tuhin37/VI-Analyzer/README.md

# VI-Analyzer
VI-Analyzer measures DC parameters like terminal voltage and load current with great precesion and loggs them
