tuhin37/VI-Analyzer/eagle/VI Analyzer/VI meter.brd

## EAGLE design eagle/VI Analyzer/VI meter.brd (2018-12-23)

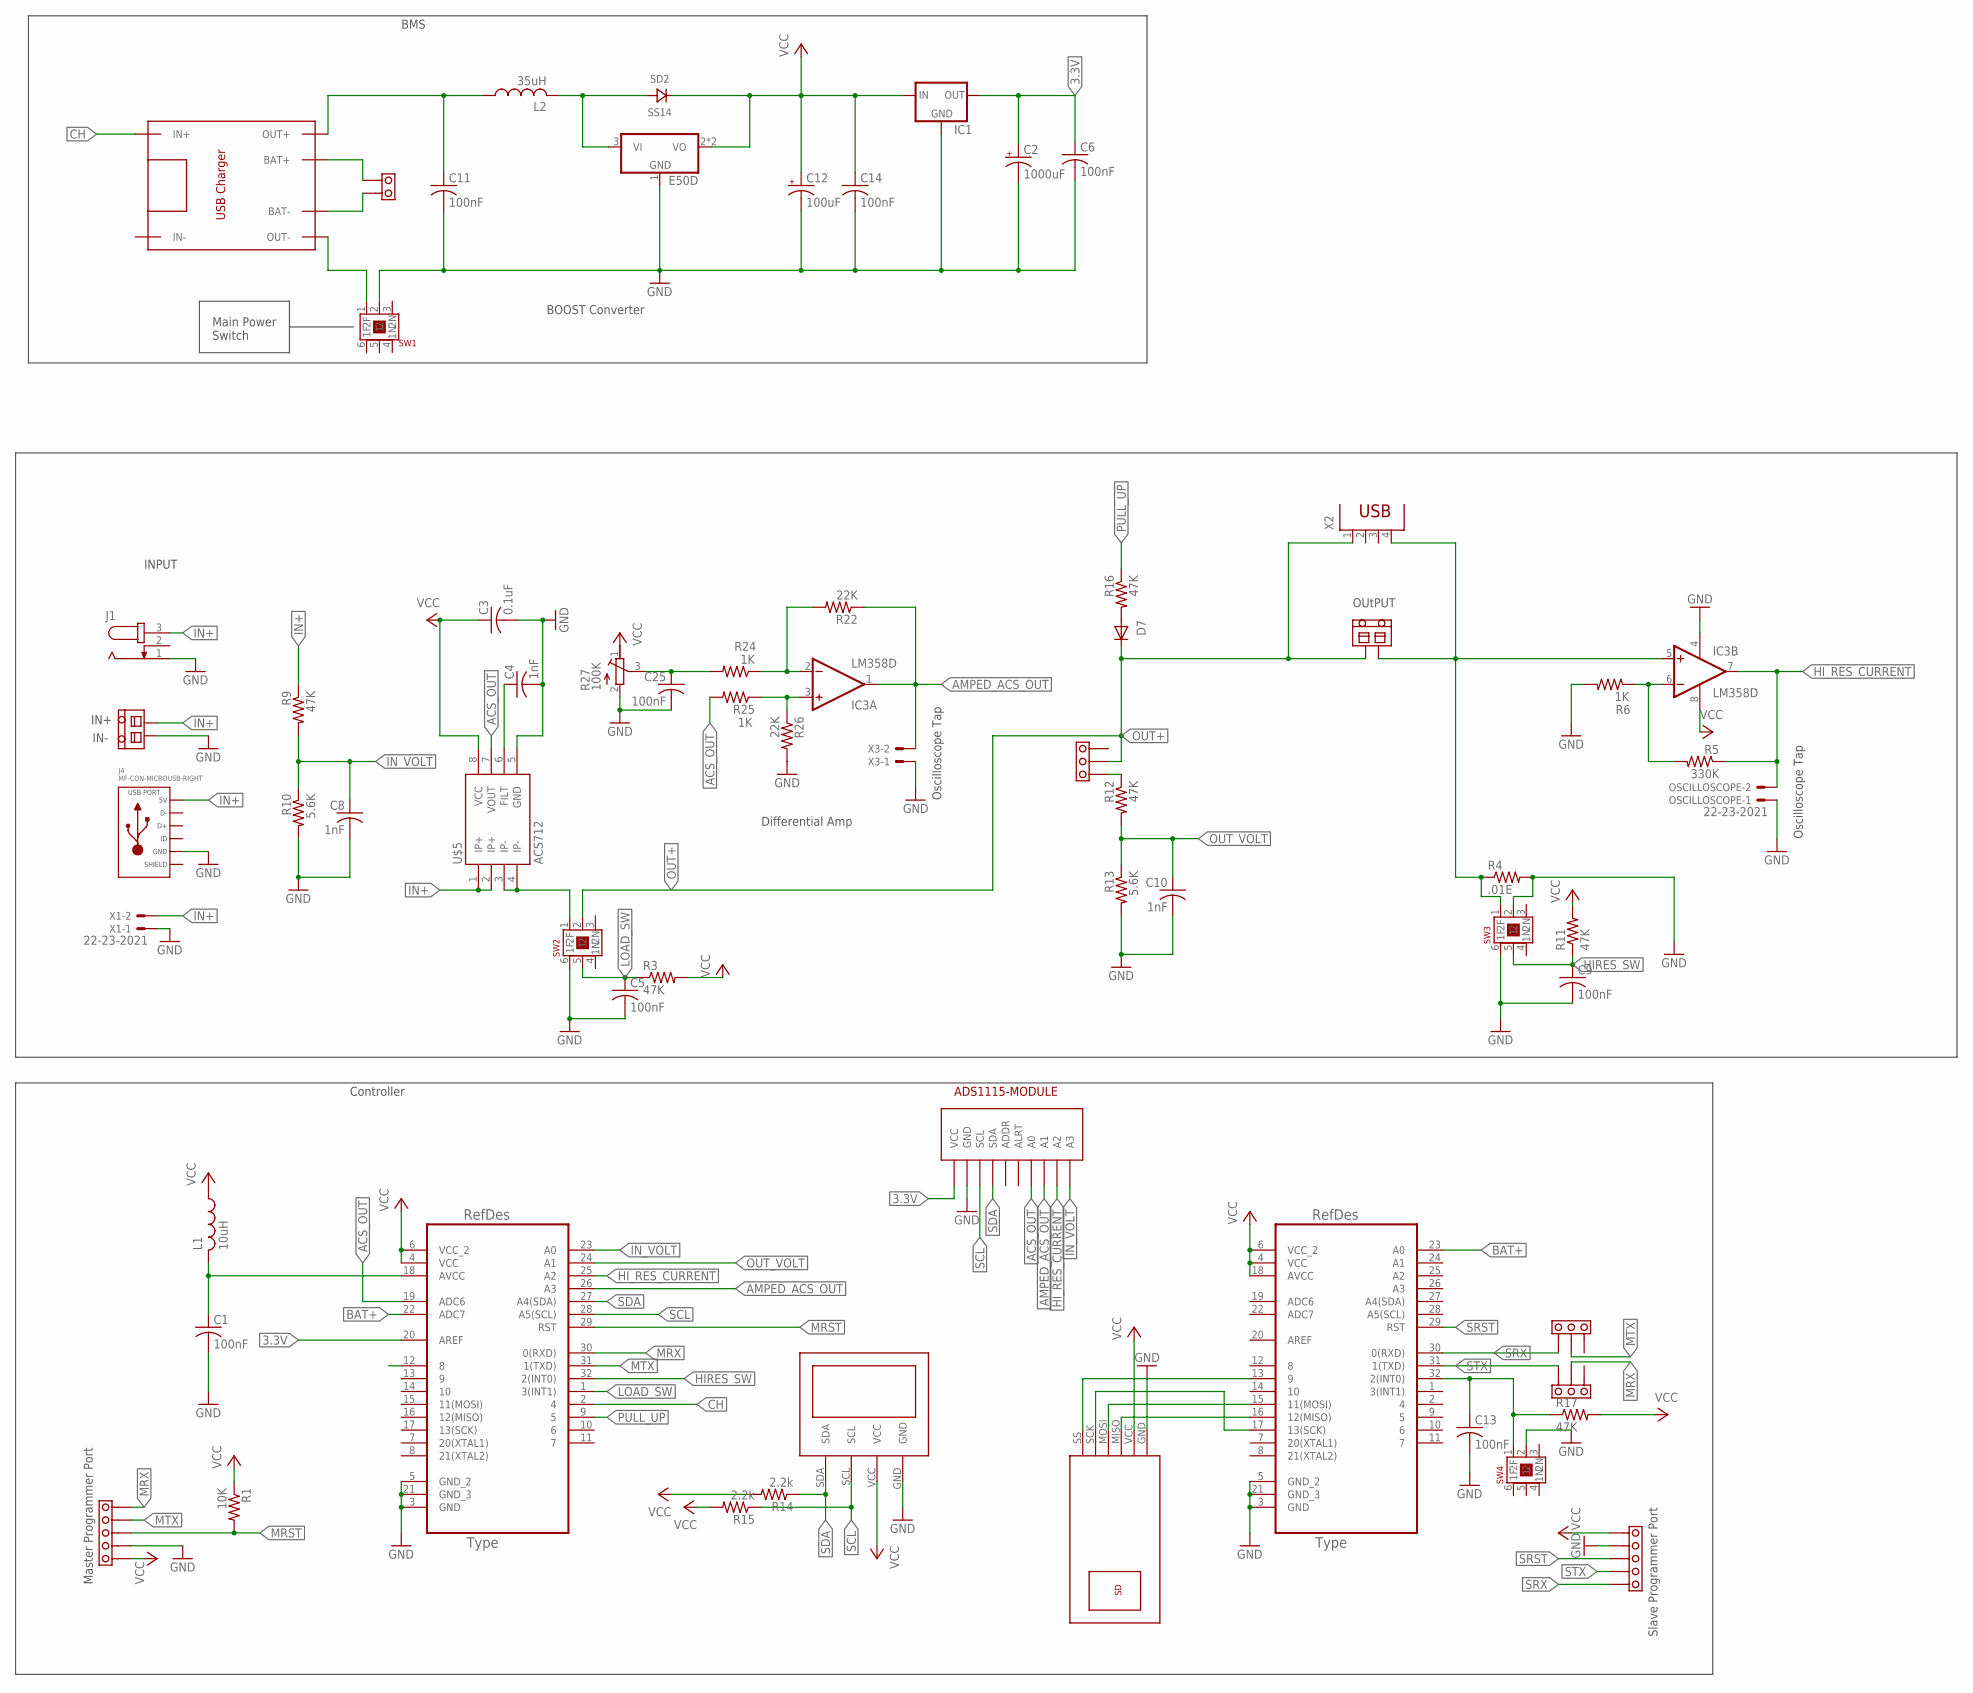
[picture p1: schematic VI meter.sch, sheet 1]

Parts:
C1, C5, C6, C9, C11, C13, C14, C25: 100nF; C1206
C2: 1000uF; 153CLV-0807
C3: 0.1uF; C1206
C4, C8, C10: 1nF; C1206
C12: 100uF; 150CLZ-0810
D7: DIODE-MINIMELF; MINIMELF
IC1: LM1117; SOT223
IC2: E50D; SOT89
IC3: LM358D; SO08
J1: JACK-PLUG1; SPC4078
J4: MF-CON-MICROUSB-RIGHT; MICROUSB-RIGHT
L1: 10uH; 0207/10
L2: 35uH; POWER-CHOKE_WE-TPC
OSCILLOSCOPE: 22-23-2021
R1: 10K; M1206
R3, R9, R11, R12, R16, R17: 47K; M1206
R4: .01E; 0617/17
R5: 330K; M1206
R6, R24, R25: 1K; M1206
R10, R13: 5.6K; M1206
R14, R15: 2.2k; M1206
R22, R26: 22K; M1206
R27: 100K; 3386P
SD2: SS14; DO214
SW1: PUSH_LATCH_SW_9X9
SW2: Load Switch; PUSH_LATCH_SW_9X9
SW3, SW4: Hi Res; PUSH_LATCH_SW_9X9
U$1, U$3: TERMINAL_BLOCK
U$2: MASTER; QFP80P900X900X120-32N
U$4, U$11: BERG_5
U$5: ACS712; SO08
U$6: TP4056
U$7: BERG_2
U$8, U$14, U$15: BERG_3
U$9: SLAVE; QFP80P900X900X120-32N
U$10: MICROSD_ARDUINO
U$12: OLED_0.96
U$13: ADS1115-MODULE
X1, X3: 22-23-2021
X2: PN87520

Connections:
3.3V: C2.+, C6.1, IC1.2 (OUT), U$2.20 (AREF), U$13.VCC
ACS_OUT: R25.2, U$2.19 (ADC6), U$5.7 (VOUT), U$13.A0
AMPED_ACS_OUT: IC3.1 (OUT), R22.1, U$2.26 (A3), U$13.A1, X3.2
BAT+: U$2.22 (ADC7), U$6.BAT+, U$7.F, U$9.23 (A0)
BAT-: U$6.BAT-, U$7.E
BOUT+: C11.1, L2.1, U$6.OUT+
CH: U$2.2 (4), U$2.12 (8), U$6.IN+
GND: C1.2, C2.-, C3.2, C4.2, C5.2, C6.2, C8.2, C9.2, C10.2, C11.2, C12.-, C13.2, C14.2, C25.2, IC1.1 (GND), IC2.1 (GND), IC3.4 (V-), J1.1, J4.5 (GND), OSCILLOSCOPE.1, R4.2, R6.2, R10.2, R13.2, R26.2, R27.2, SW1.2 (1), SW2.6 (2F), SW3.2 (1), SW3.6 (2F), SW4.2 (1), U$1.2, U$2.3 (GND), U$2.5 (GND_2), U$2.21 (GND_3), U$4.H, U$5.5 (GND), U$9.3 (GND), U$9.5 (GND_2), U$9.21 (GND_3), U$10.GND, U$11.H, U$12.GND, U$13.GND, X1.1, X3.1
HIRES_SW: C9.1, R11.1, SW3.5 (2), U$2.32 (2(INT0))
HI_RES_CURRENT: IC3.7 (OUT), OSCILLOSCOPE.2, R5.1, U$2.25 (A2), U$13.A2
IN+: J1.3, J4.1 (5V), R9.1, U$1.1, U$5.1 (IP+), U$5.2 (IP+), X1.2
IN_VOLT: C8.1, R9.2, R10.1, U$2.23 (A0), U$13.A3
LOAD-: IC3.5 (+IN), R4.1, SW3.1 (1F), U$3.1, X2.4
LOAD_SW: C5.1, R3.1, SW2.5 (2), U$2.1 (3(INT1))
MRST: R1.2, U$2.29 (RST), U$4.G
MRX: U$2.30 (0(RXD)), U$4.E, U$15.F
MTX: U$2.31 (1(TXD)), U$4.F, U$14.F
unnamed: C1.1, L1.2, U$2.18 (AVCC)
unnamed: IC2.3 (VI), L2.2, SD2.ANODE
unnamed: C4.1, U$5.6 (FILT)
unnamed: IC3.6 (-IN), R5.2, R6.1
unnamed: R12.1, U$8.G
unnamed: SW2.1 (1F), U$5.3 (IP-), U$5.4 (IP-)
unnamed: U$9.16 (12(MISO)), U$10.MISO
unnamed: U$9.15 (11(MOSI)), U$10.MOSI
unnamed: U$9.17 (13(SCK)), U$10.SCK
unnamed: D7.A, R16.2
unnamed: U$9.13 (9), U$10.SS (CS)
unnamed: C13.1, R17.1, SW4.1 (1F), U$9.32 (2(INT0))
unnamed: IC3.2 (-IN), R22.2, R24.1
unnamed: IC3.3 (+IN), R25.1, R26.1
OUT+: D7.C, SW2.2 (1), U$3.2, U$8.F, X2.1
OUT-: SW1.1 (1F), U$6.OUT-
OUT_VOLT: C10.1, R12.2, R13.1, U$2.24 (A1)
POT_OFFSET: C25.1, R24.2, R27.3
PULL_UP: R16.1, U$2.9 (5)
SCL: R15.1, U$2.28 (A5(SCL)), U$12.SCL, U$13.SCL
SDA: R14.1, U$2.27 (A4(SDA)), U$12.SDA, U$13.SDA
SLD: J4.S1 (SLD), J4.S2 (SLD), J4.S3 (SLD), J4.S4 (SLD), J4.S5 (SLD), J4.S6 (SLD)
SRST: U$9.29 (RST), U$11.G
SRX: U$9.30 (0(RXD)), U$11.E, U$14.G
STX: U$9.31 (1(TXD)), U$11.F, U$15.E
VCC: C3.1, C12.+, C14.1, IC1.3 (IN), IC2.2 (VO), IC2.2@1 (VO), IC3.8 (V+), L1.1, R1.1, R3.2, R11.2, R14.2, R15.2, R17.2, R27.1, SD2.CATHODE, U$2.4 (VCC), U$2.6 (VCC_2), U$4.I, U$5.8 (VCC), U$9.4 (VCC), U$9.6 (VCC_2), U$9.18 (AVCC), U$10.VCC, U$11.I, U$12.VCC

Notes on the sheet:
BOOST Converter
Main Power Switch
Master Programmer Port
INPUT
IN+
IN-
BMS
Controller
OUtPUT
Differential Amp
Slave Programmer Port
Oscilloscope Tap

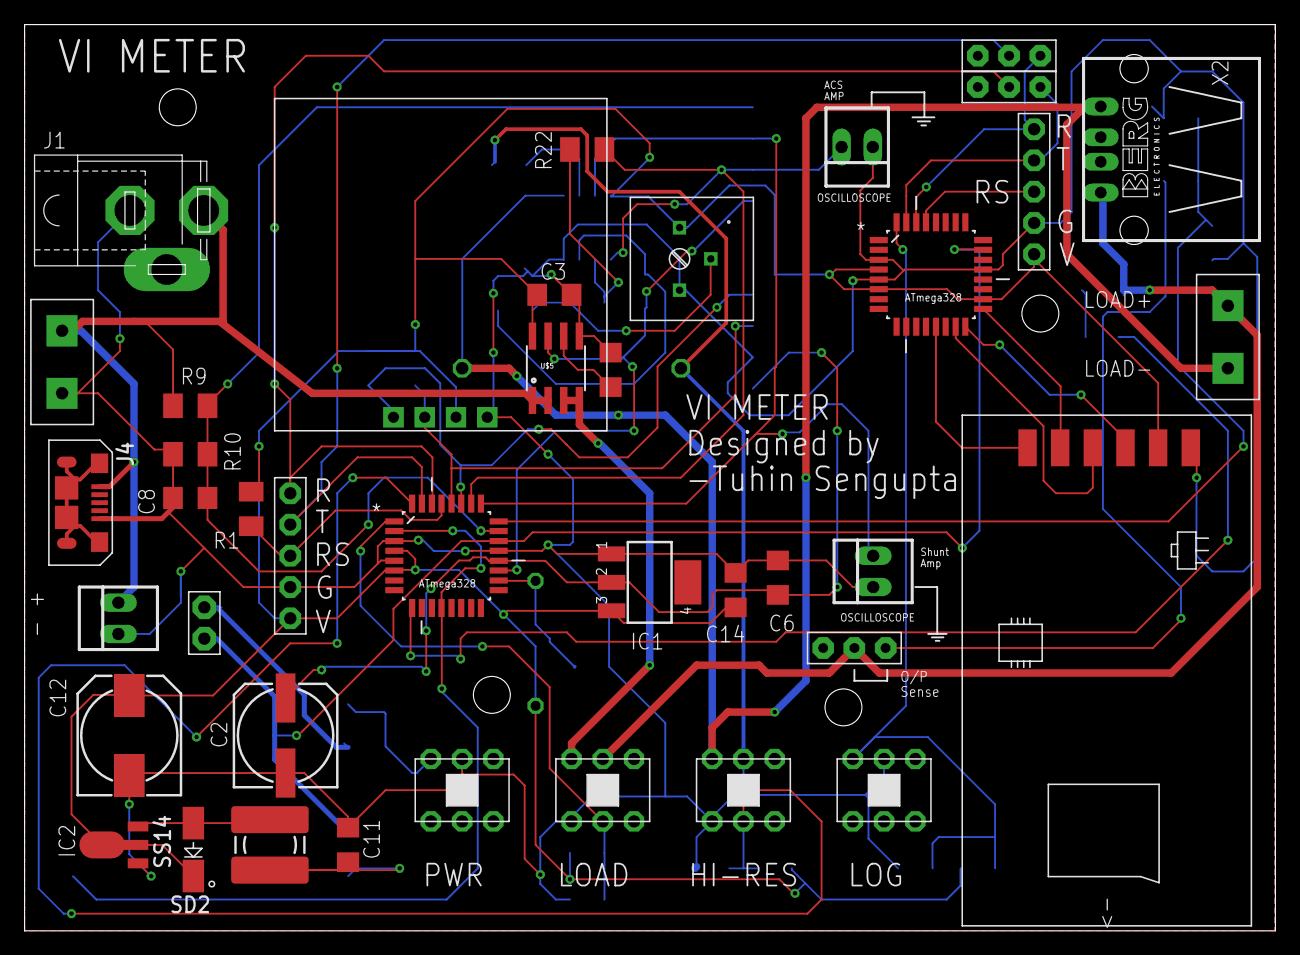
[picture p2: board VI meter.brd from above]

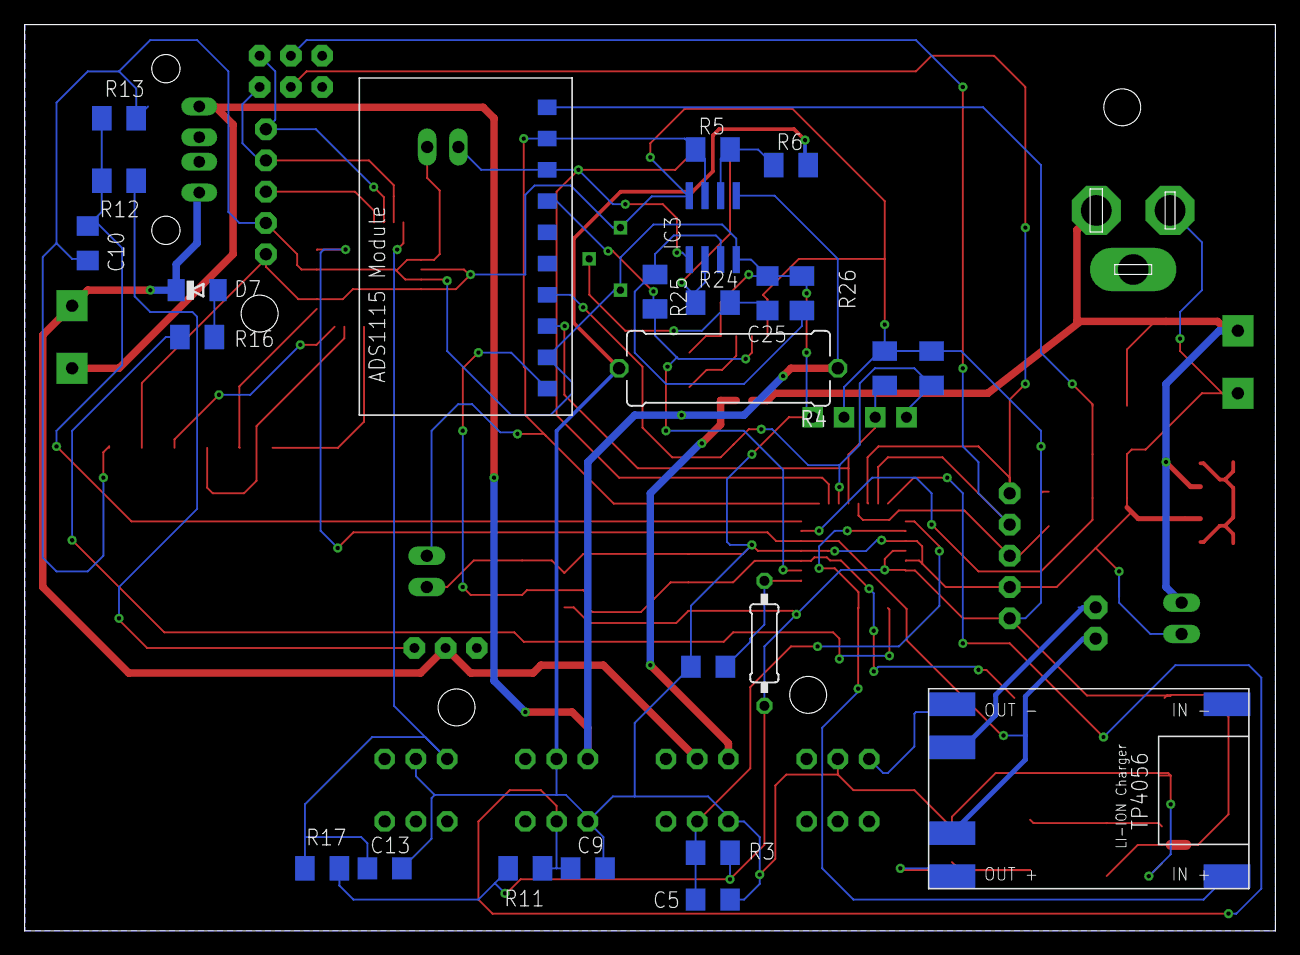
[picture p3: board VI meter.brd from below]

Board: 2 copper layers, 101.7 x 73.7 mm, 65 parts (25 on the bottom side), 43 nets.
