tuhin37/VI-Analyzer/arduino/master/config.h

// **************** SWITCH PINS ****************
#define HI_RES_PIN 2
#define LOAD_PIN 3


#define CHARGE_PIN 4

// Battery PIN
#define BATT_PIN A7


// Battery Full (ADC : 810  ->  3.959V)
#define BATTERYMAX 810

// Battery Low cutoff (ADC : 655 >  3.2V)
#define BATTERYMIN 655

// ADC PINS
#define SRC_VOLT_PIN A0
#define LOAD_VOLT_PIN A1
#define HD_CURR_PIN A2


//ADS PIN
#define ADS_SRC_VOLT_PIN 3
#define ADS_HD_CURR_PIN 2
#define ADS_ACS_PIN 0
#define ADS_AMPED_ACS_PIN 1


//MISC
#define PULL_UP 5
