tuhin37/VI-Analyzer/(commit log)

2018-08-29 ADD: Initial adding of existing files
    [VI meter.brd, VI meter.sch]
2018-08-30 EDIT: Allignment of Current value EDIT: Extended the range of resistances ADD: 'OPEN' and 'SHORT' Display for resistance when out of range
    [VI-Analyzer.ino, aquire.h, oled.h]
2018-09-03 ADD: Hi res current reading from ads1115
    [VI meter.brd, VI meter.sch]
2018-12-06 Fix: moved the shunt to the lower side, single channel amp instead of differential
    [VI meter.brd, VI meter.sch]
2018-12-23 Edit: fixed source voltage, can be improved with more granular peice-wise equations
    [VI meter.brd, VI meter.sch]
